danishsajjad/Tic-Tac-Toe/README.md

# Tic-Tac-Toe
 DLD Project. Game made from logic ICs.
