danishsajjad/Tic-Tac-Toe/images/Schematic-Sliced_01.gif

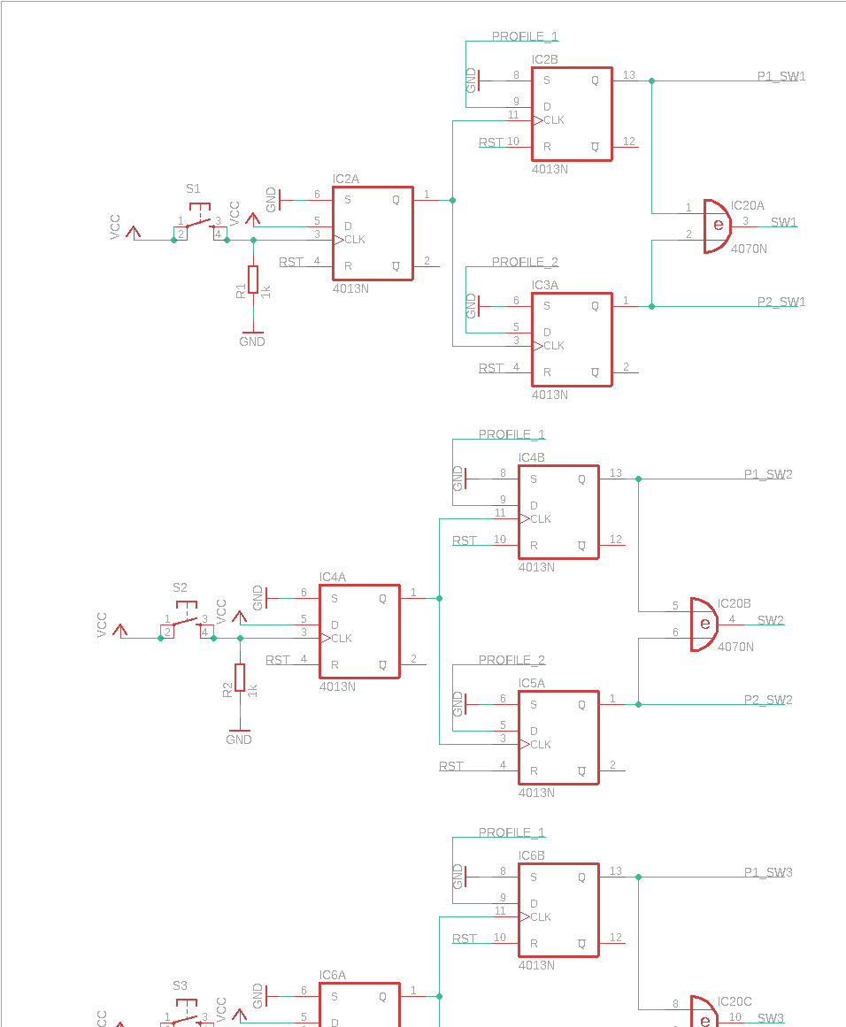
images/Schematic-Sliced_01.gif
