danishsajjad/Tic-Tac-Toe/images/Schematic-Sliced_02.png

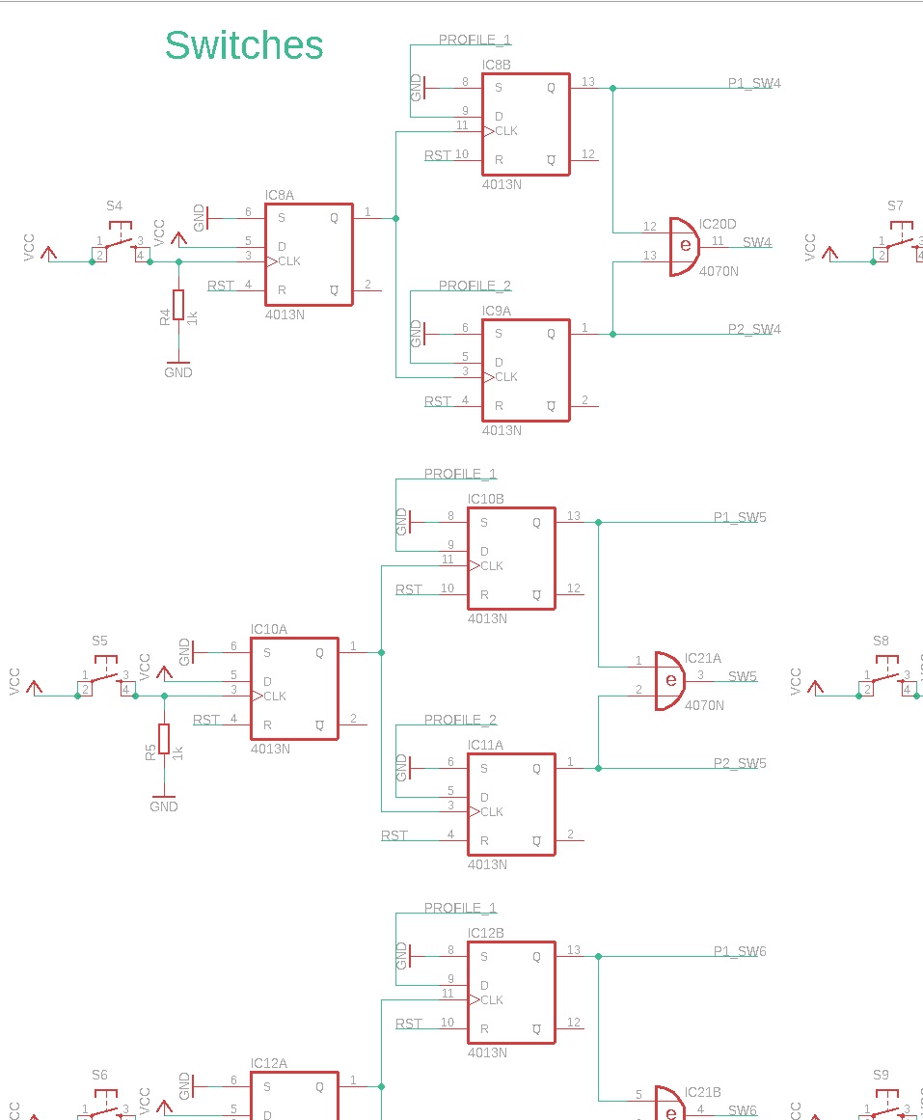
images/Schematic-Sliced_02.png
