danishsajjad/Tic-Tac-Toe/images/Schematic-Sliced_03.gif

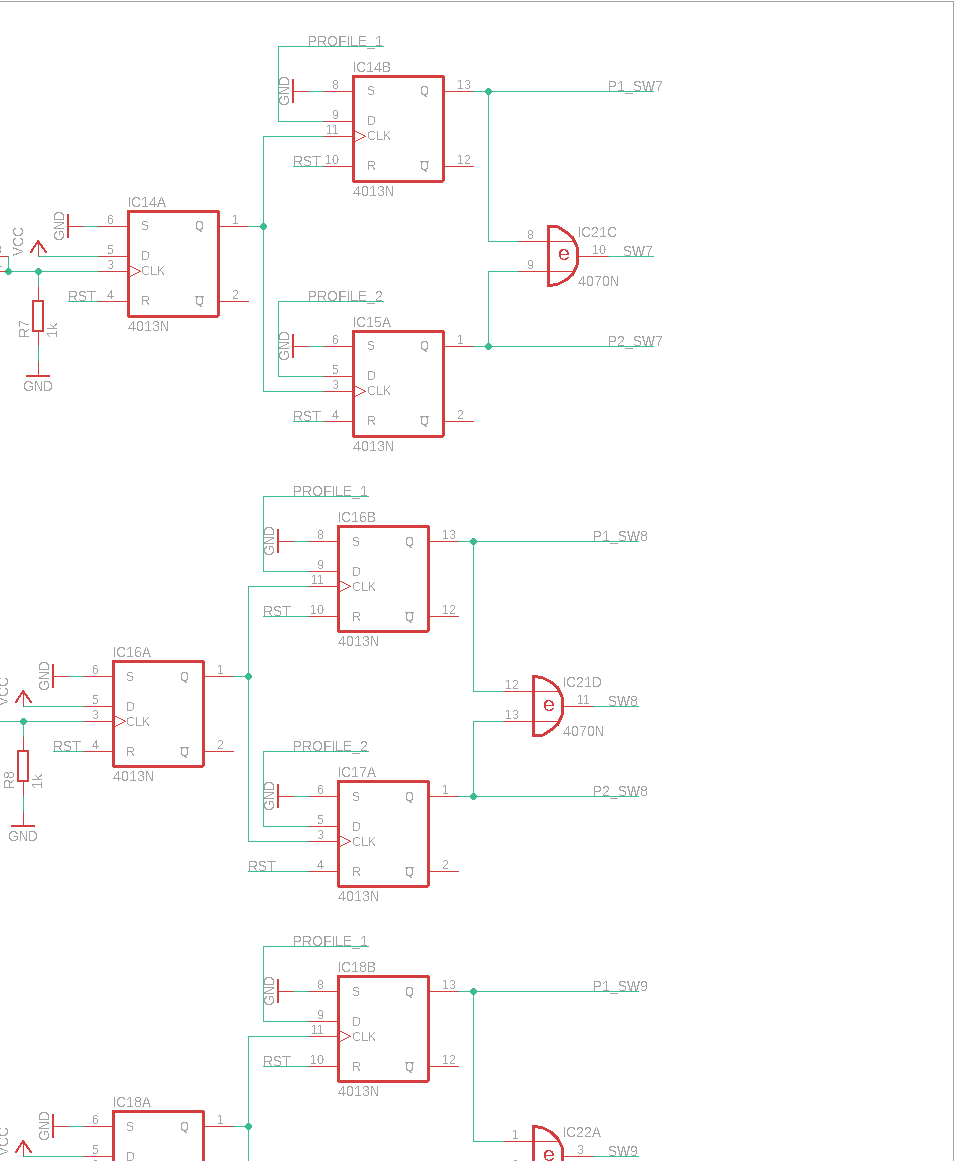
images/Schematic-Sliced_03.gif
