danishsajjad/Tic-Tac-Toe/images/Schematic-Sliced_04.gif

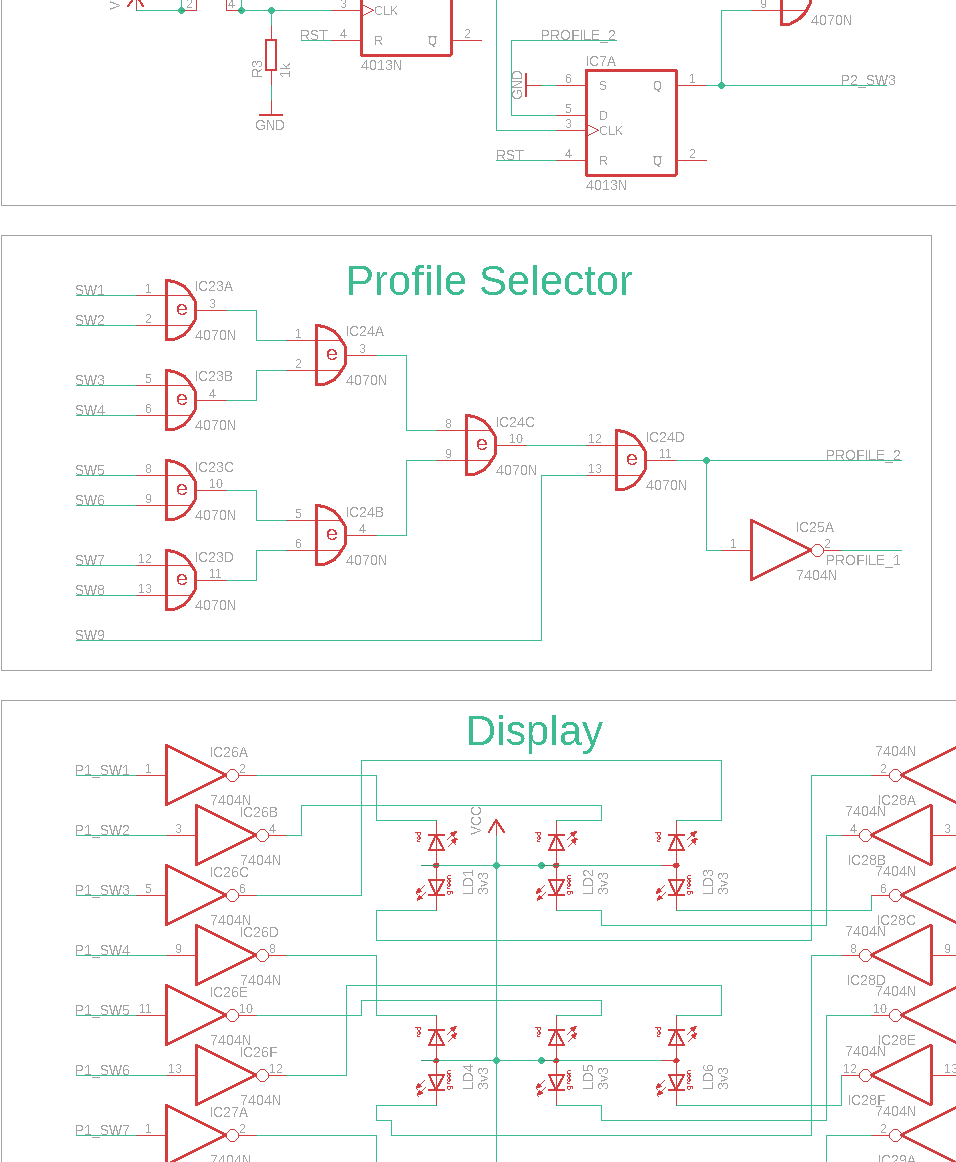
images/Schematic-Sliced_04.gif
