danishsajjad/Tic-Tac-Toe/images/Schematic-Sliced_05.gif

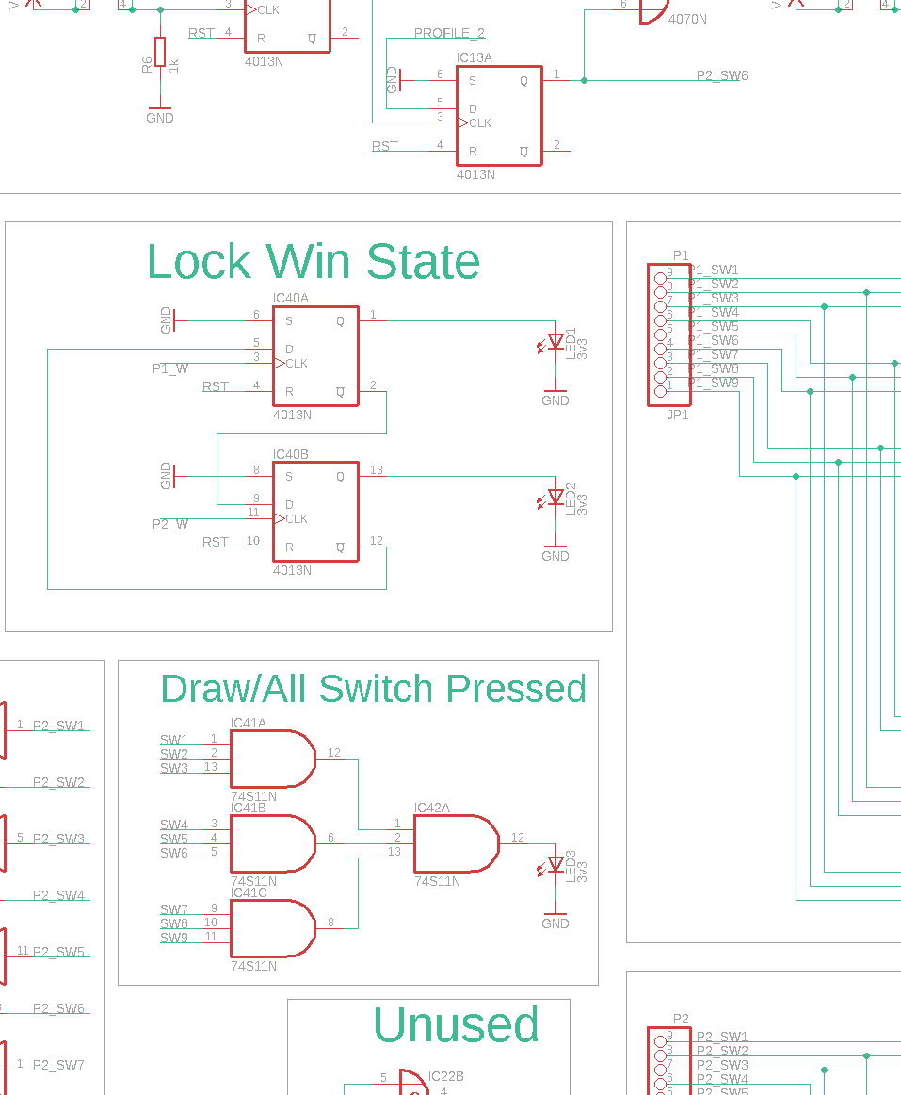
images/Schematic-Sliced_05.gif
