danishsajjad/Tic-Tac-Toe/images/Schematic-Sliced_06.gif

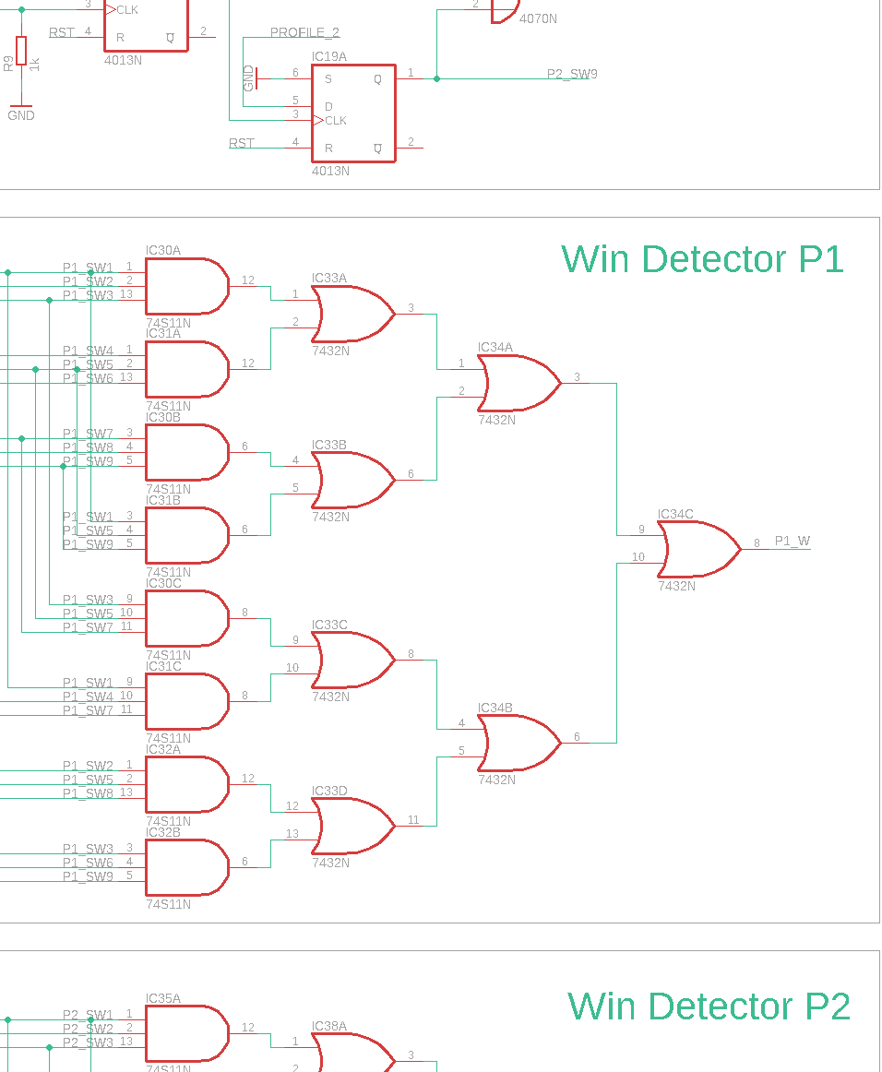
images/Schematic-Sliced_06.gif
