danishsajjad/Tic-Tac-Toe/images/Schematic-Sliced_07.gif

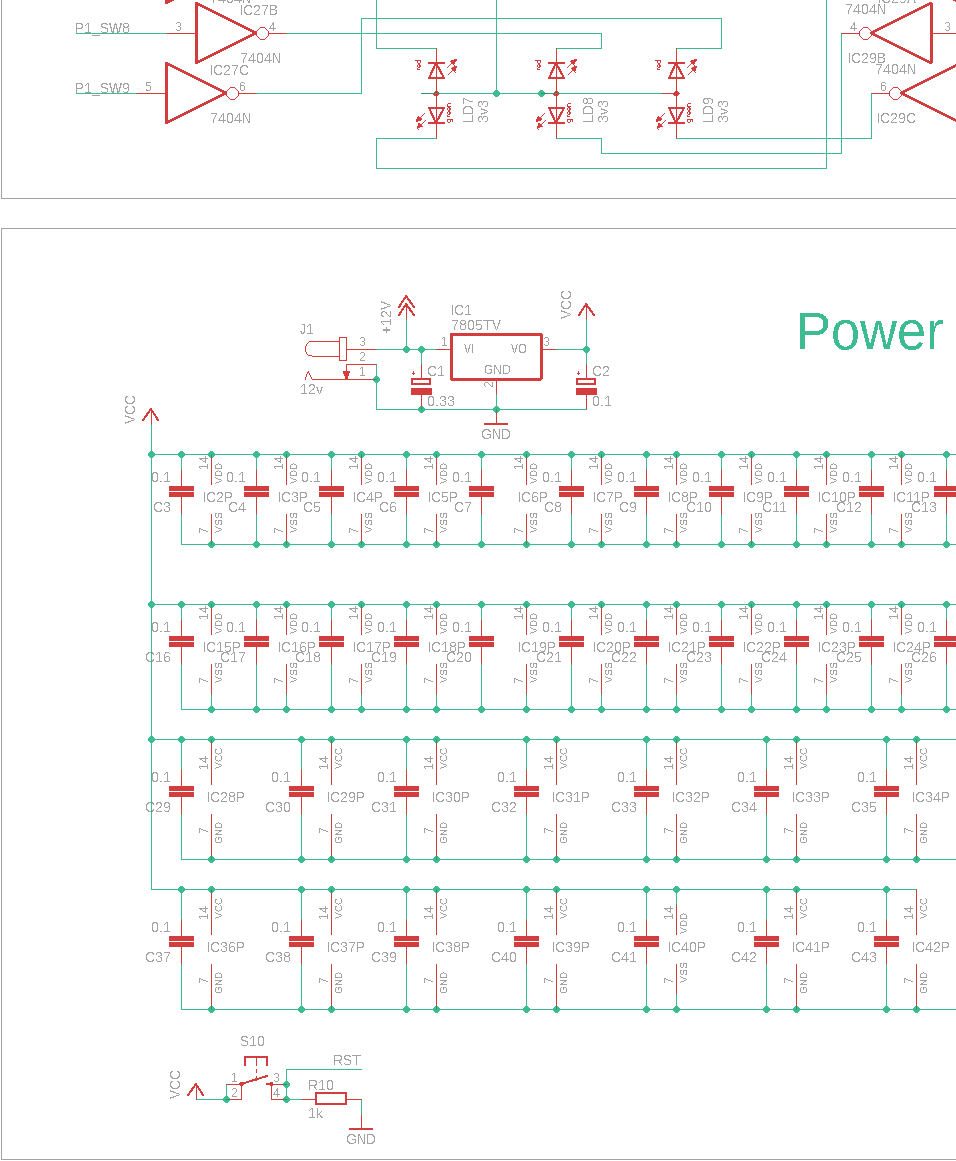
images/Schematic-Sliced_07.gif
