danishsajjad/Tic-Tac-Toe/images/Schematic-Sliced_08.gif

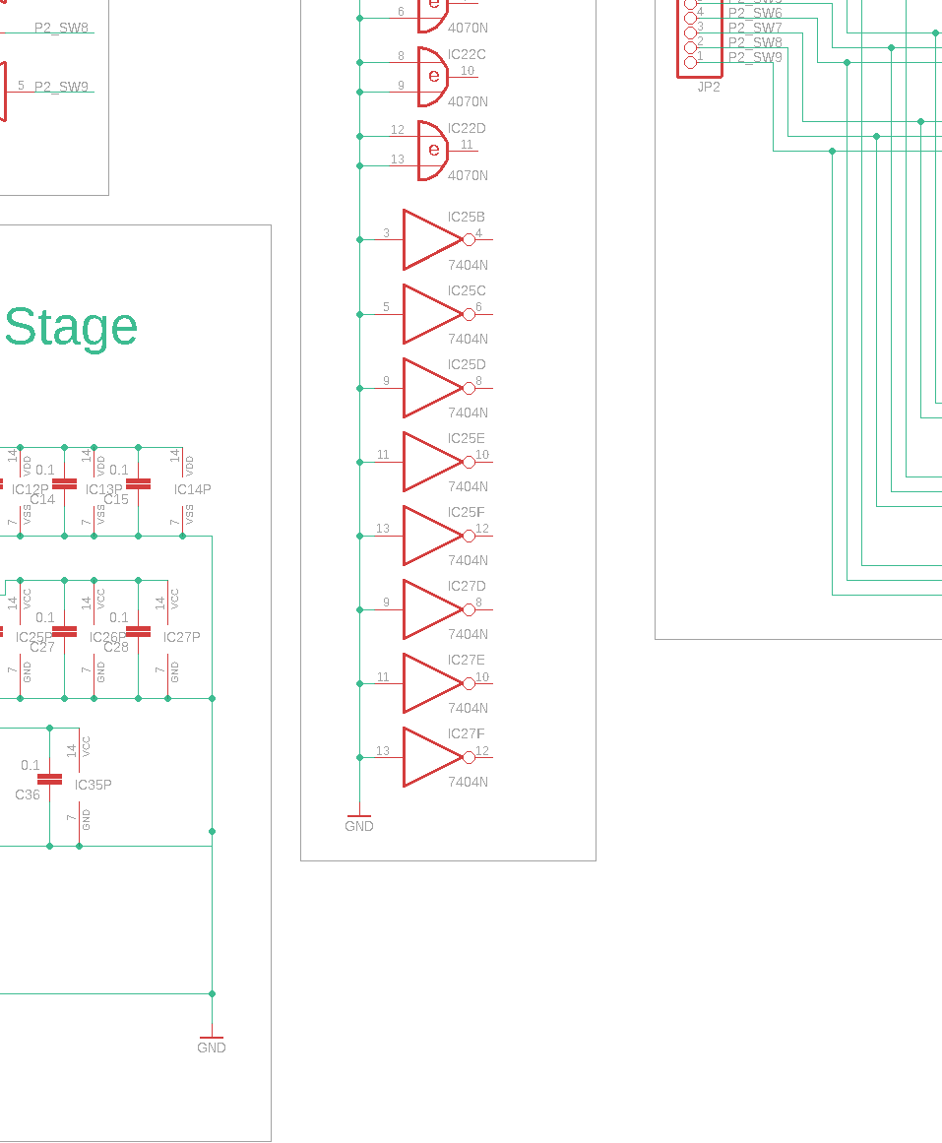
images/Schematic-Sliced_08.gif
