danishsajjad/Tic-Tac-Toe/images/Schematic-Sliced_09.gif

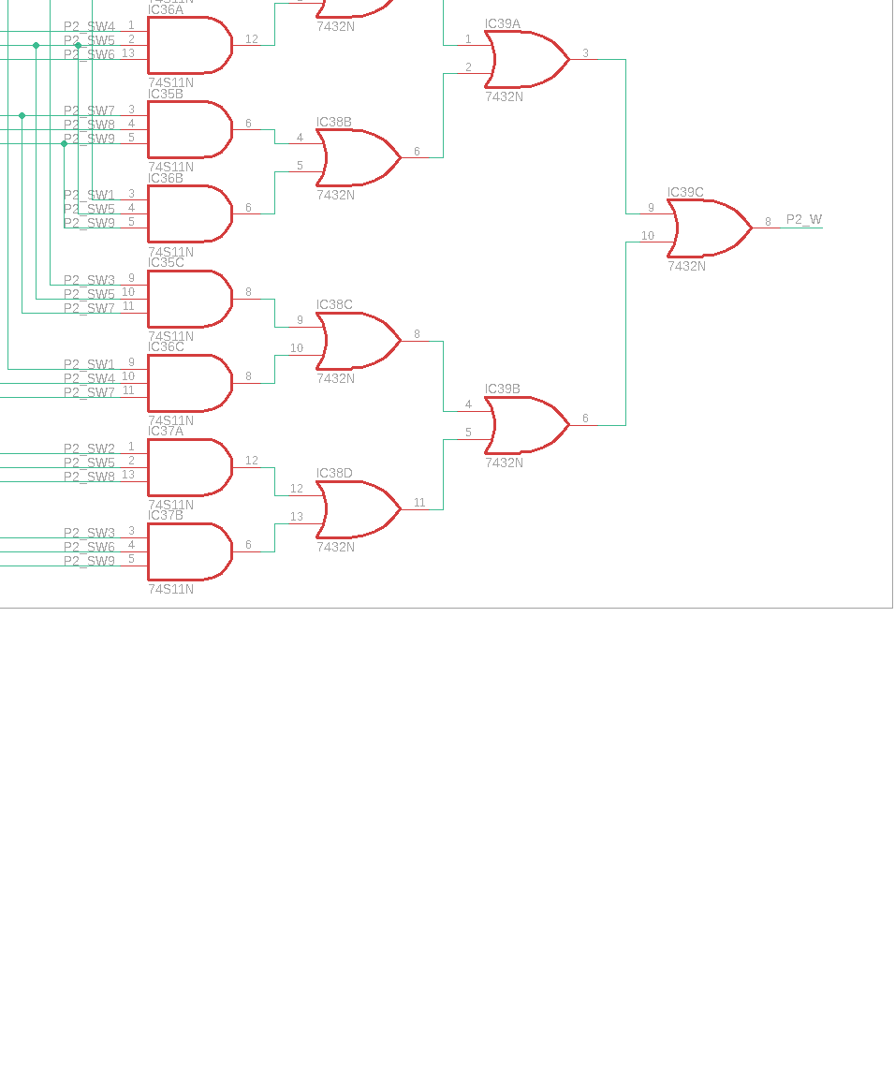
images/Schematic-Sliced_09.gif
