danishsajjad/Tic-Tac-Toe/Lab Report/Draw Indicator.PNG

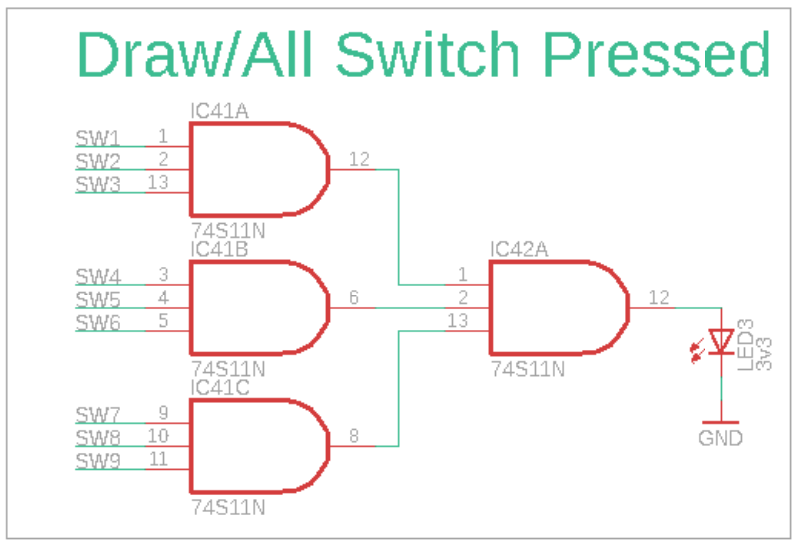
Lab Report/Draw Indicator.PNG
