danishsajjad/Tic-Tac-Toe/Lab Report/Input Stage.PNG

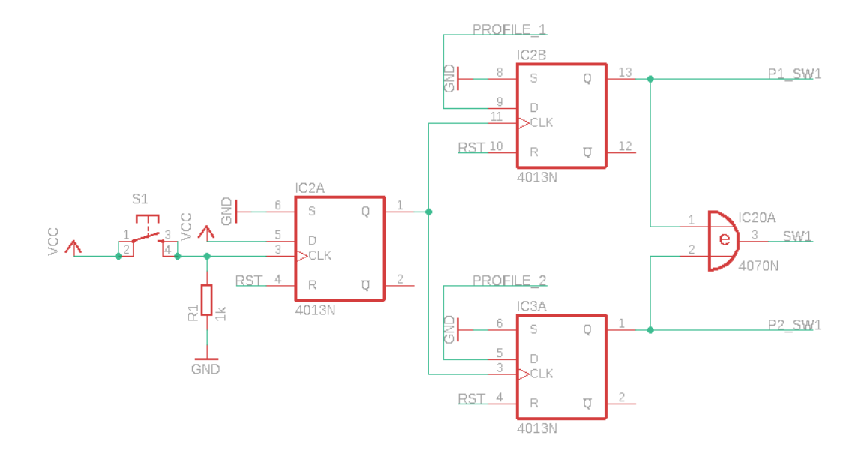
Lab Report/Input Stage.PNG
