danishsajjad/Tic-Tac-Toe/Lab Report/Lock Win State.PNG

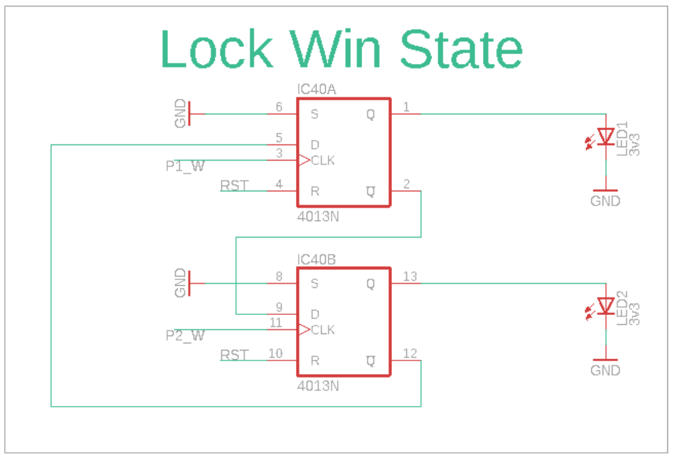
Lab Report/Lock Win State.PNG
