danishsajjad/Tic-Tac-Toe/Lab Report/Profile Selector.PNG

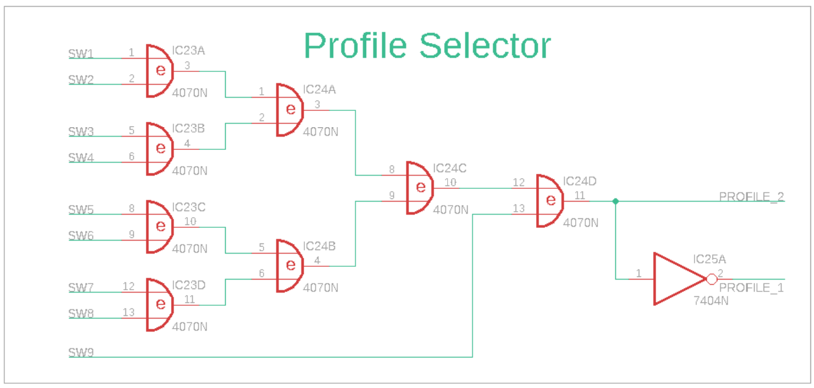
Lab Report/Profile Selector.PNG
