danishsajjad/Tic-Tac-Toe/Lab Report/Win Detector.PNG

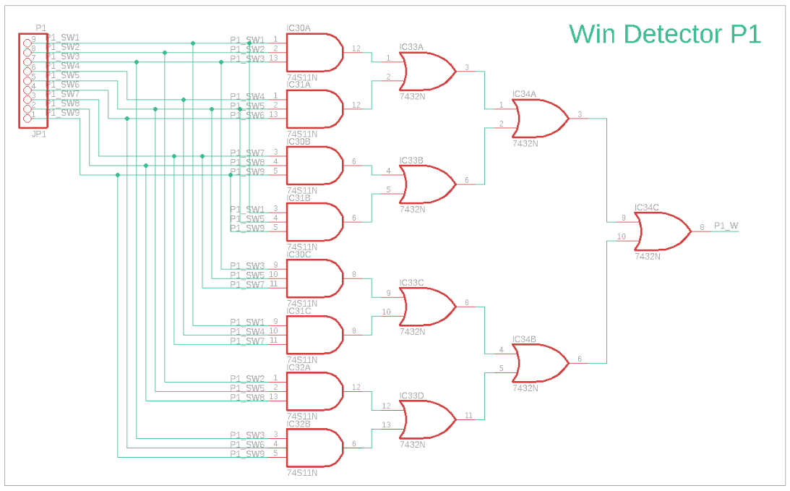
Lab Report/Win Detector.PNG
