danishsajjad/Tic-Tac-Toe/Schematic Sliced.png

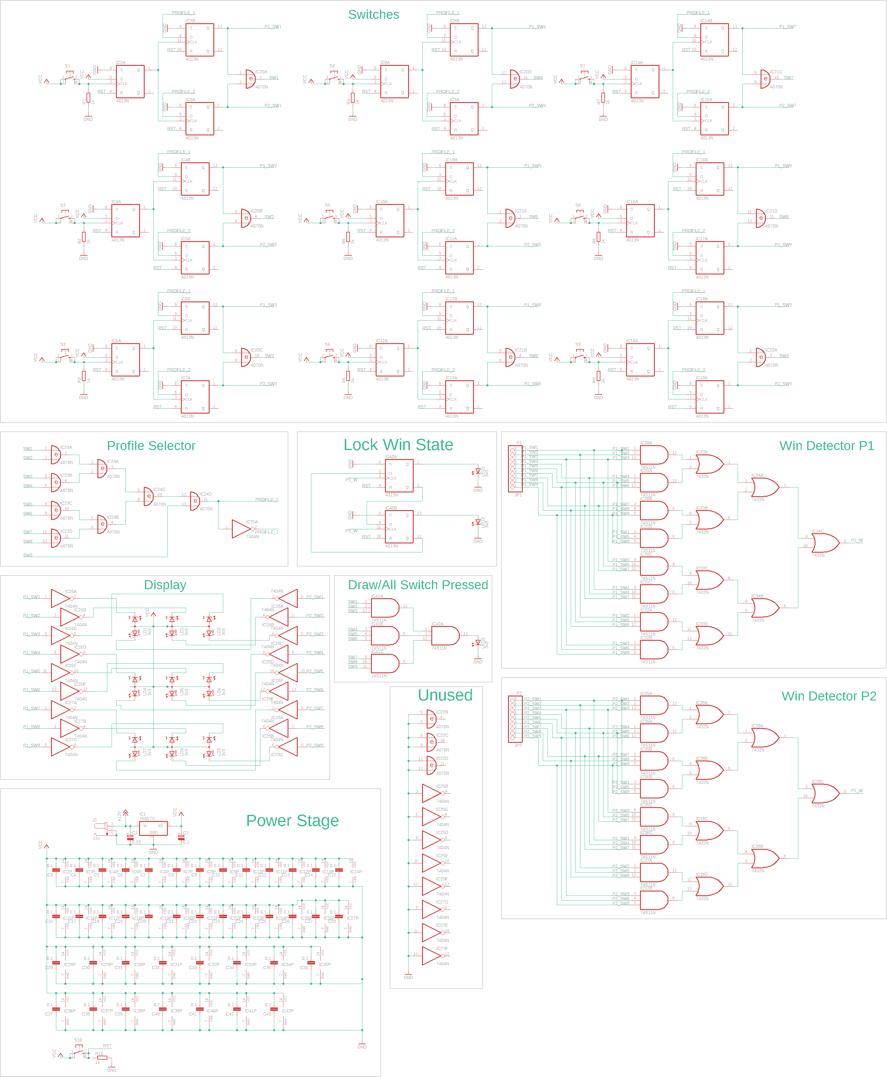
Schematic Sliced.png
