danishsajjad/Tic-Tac-Toe/BOM.xlsx

Qty | Value | Device | Description
10 |  | TAC_SWITCHPTH | Momentary Switch
10 | 1k | R-EU_0207/7 | RESISTOR, European symbol
9 | 3v3 | DUOLED-RG-A | Two Color LED
3 | 3v3 | LED5MM | LED
19 | 4013N | 4013N | Dual D FLIP FLOP, set/reset
5 | 4070N | 4070N | Quad 2-input XOR
5 | 7404N | 7404N | Hex INVERTER
4 | 7432N | 7432N | Quad 2-input OR gate
8 | 74S11N | 74S11N | Triple 3-input AND gate
5 | - | Breadboard | Breadboard
