danishsajjad/Tic-Tac-Toe/(list of files, drawings)

Other design files:
Simulation/Design1.ms13
