danishsajjad/Tic-Tac-Toe/Tic Tac Toe/untitled.sch

## EAGLE design Tic Tac Toe/untitled.sch (2021-04-01)

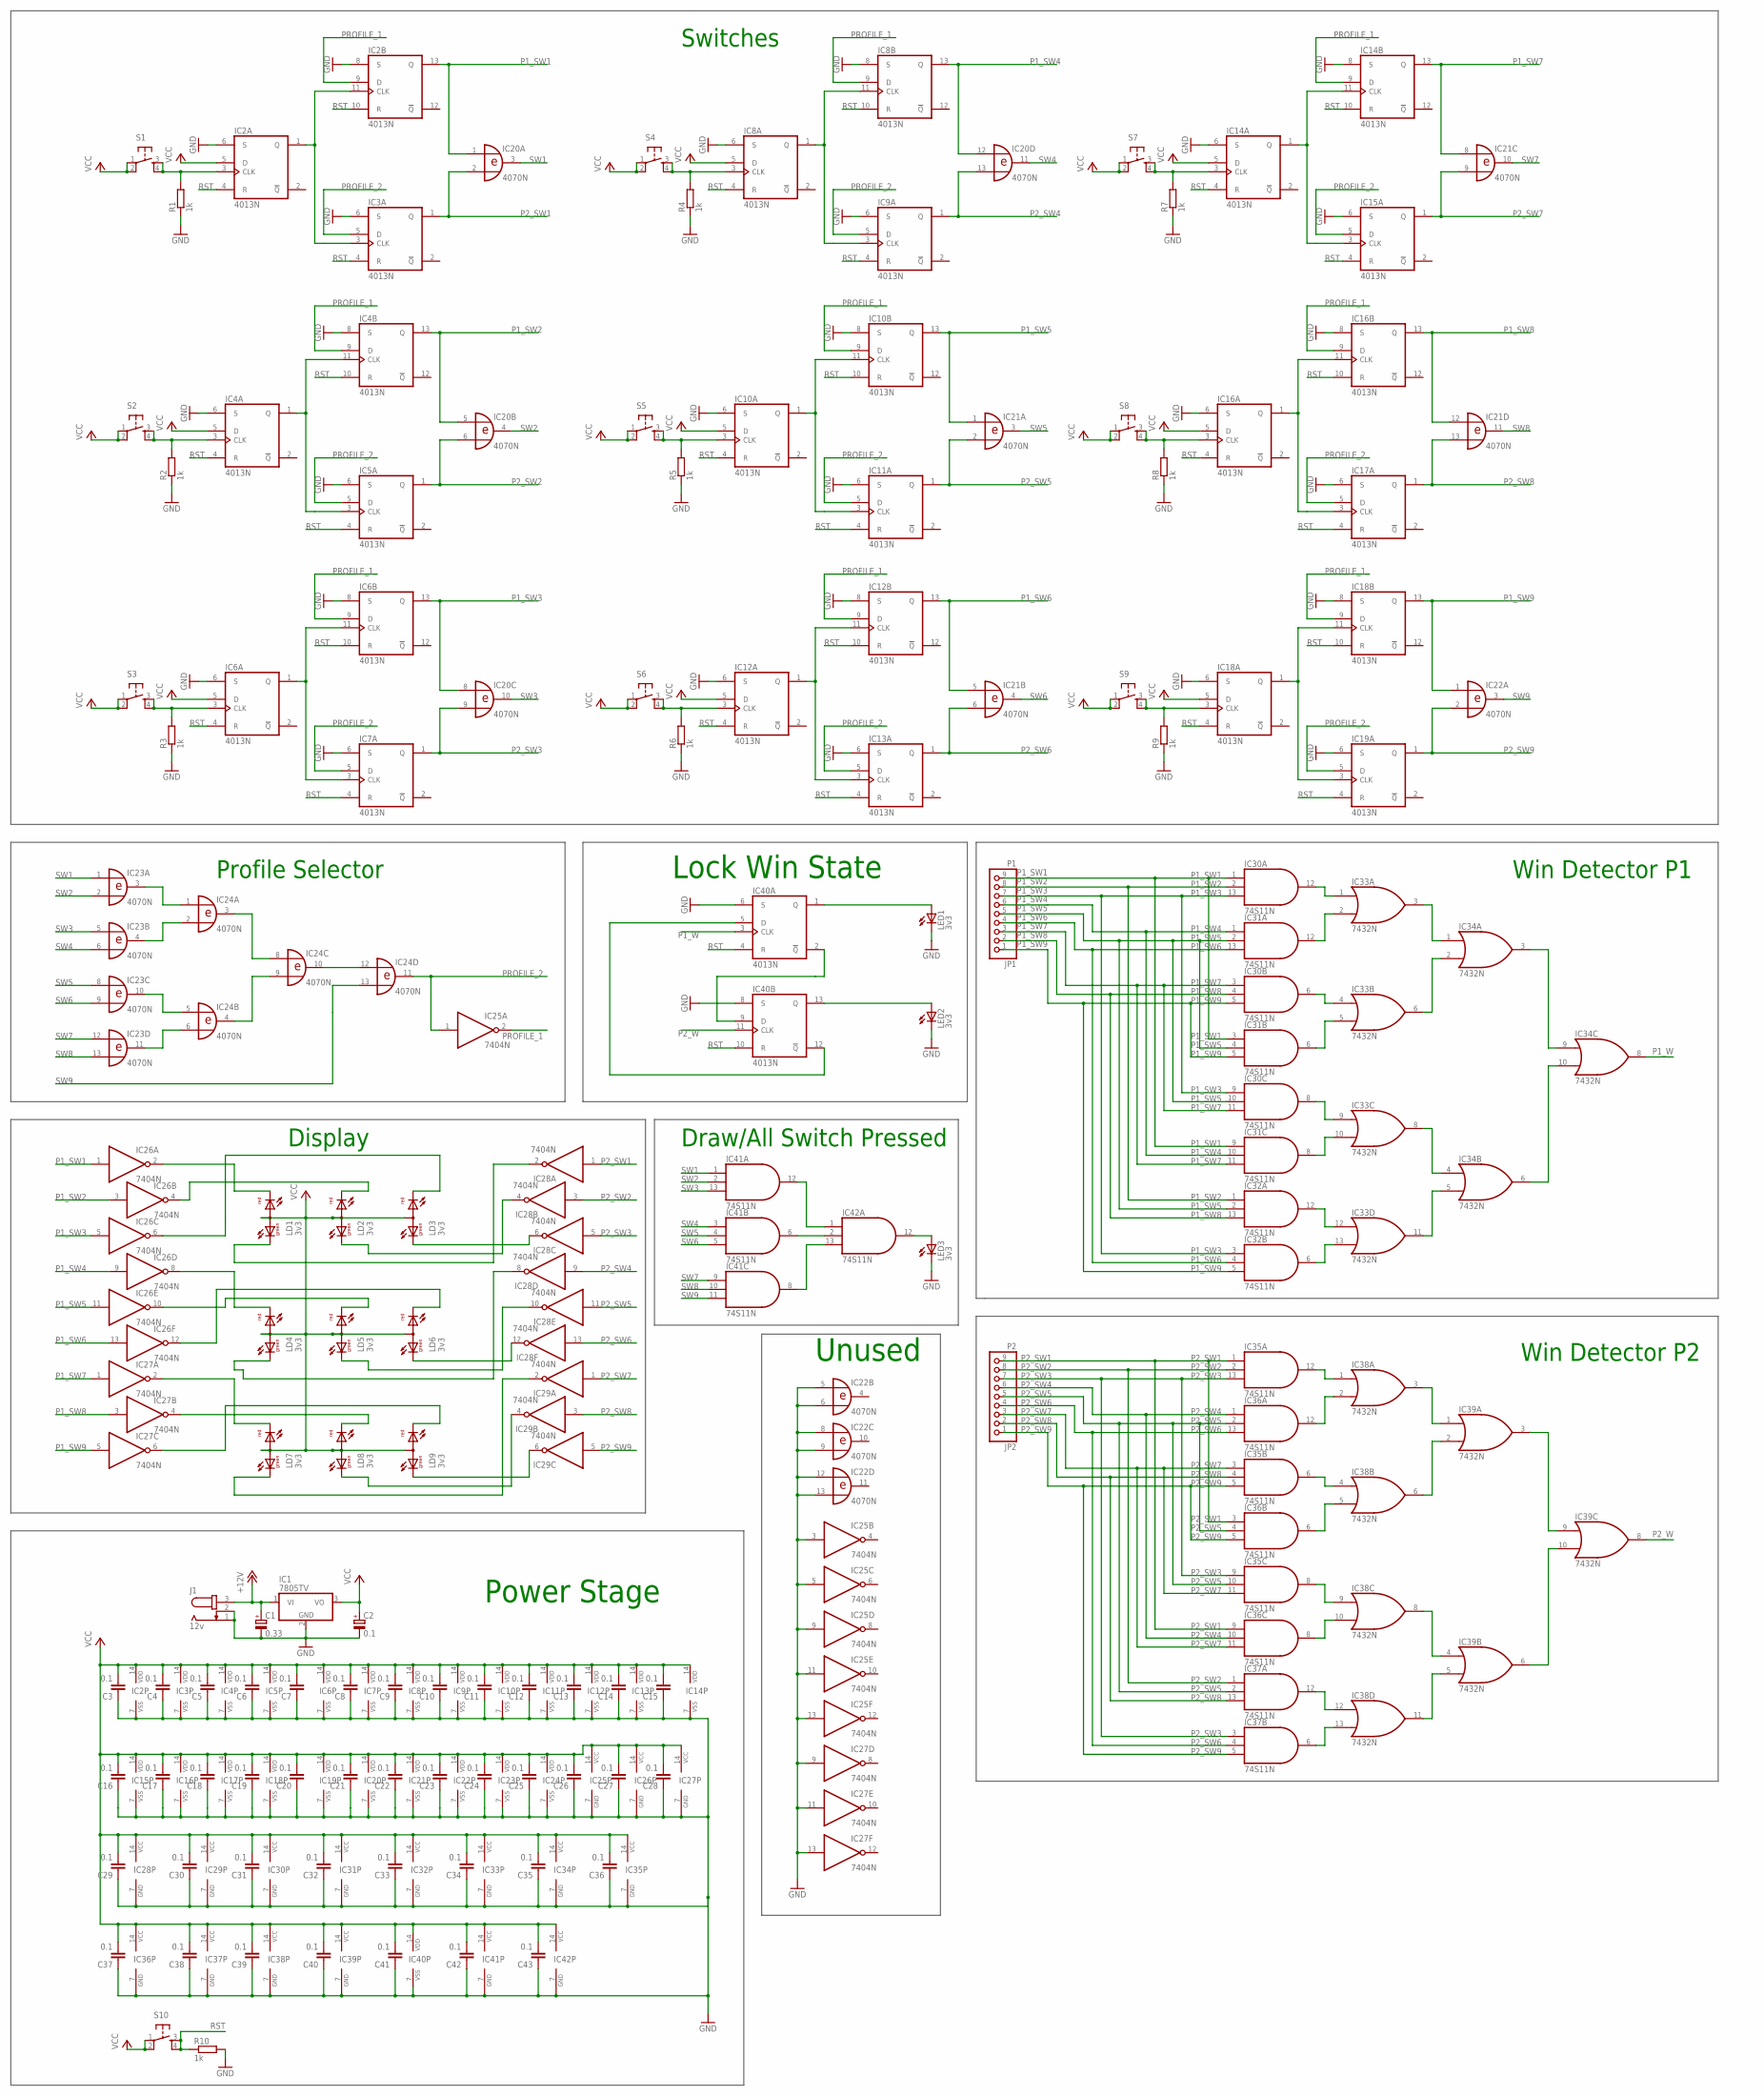
[picture p24: schematic untitled.sch]

Parts:
C1: 0.33; E5-8,5
C2: 0.1; E5-8,5
C3, C4, C5, C6, C7, C8, C9, C10, C11, C12, C13, C14, C15, C16, C17, C18, C19, C20, C21, C22, C23, C24, C25, C26, C27, C28, C29, C30, C31, C32, C33, C34, C35, C36, C37, C38, C39, C40, C41, C42, C43: 0.1; C025-050X050
IC1: 7805TV; TO220V
IC2, IC3, IC4, IC5, IC6, IC7, IC8, IC9, IC10, IC11, IC12, IC13, IC14, IC15, IC16, IC17, IC18, IC19, IC40: 4013N; DIL14
IC20, IC21, IC22, IC23, IC24: 4070N; DIL14
IC25, IC26, IC27, IC28, IC29: 7404N; DIL14
IC30, IC31, IC32, IC35, IC36, IC37, IC41, IC42: 74S11N; DIL14
IC33, IC34, IC38, IC39: 7432N; DIL14
J1: 12v; SPC4077
JP1: P1; 1X09/90
JP2: P2; 1X09/90
LD1, LD2, LD3, LD4, LD5, LD6, LD7, LD8, LD9: 3v3; DUOLED-A-5MM
LED1, LED2, LED3: 3v3; LED5MM
R1, R2, R3, R4, R5, R6, R7, R8, R9, R10: 1k; 0207/7
S1, S2, S3, S4, S5, S6, S7, S8, S9, S10: TAC_SWITCHPTH; TACTILE-PTH

Connections:
+12V: C1.+, IC1.1 (VI), J1.3
GND: C1.-, C2.-, C3.1, C4.1, C5.1, C6.1, C7.1, C8.1, C9.1, C10.1, C11.1, C12.1, C13.1, C14.1, C15.1, C16.1, C17.1, C18.1, C19.1, C20.1, C21.1, C22.1, C23.1, C24.1, C25.1, C26.1, C27.1, C28.1, C29.1, C30.1, C31.1, C32.1, C33.1, C34.1, C35.1, C36.1, C37.1, C38.1, C39.1, C40.1, C41.1, C42.1, C43.1, IC1.2 (GND), IC2.6 (S), IC2.7 (VSS), IC2.8 (S), IC3.6 (S), IC3.7 (VSS), IC4.6 (S), IC4.7 (VSS), IC4.8 (S), IC5.6 (S), IC5.7 (VSS), IC6.6 (S), IC6.7 (VSS), IC6.8 (S), IC7.6 (S), IC7.7 (VSS), IC8.6 (S), IC8.7 (VSS), IC8.8 (S), IC9.6 (S), IC9.7 (VSS), IC10.6 (S), IC10.7 (VSS), IC10.8 (S), IC11.6 (S), IC11.7 (VSS), IC12.6 (S), IC12.7 (VSS), IC12.8 (S), IC13.6 (S), IC13.7 (VSS), IC14.6 (S), IC14.7 (VSS), IC14.8 (S), IC15.6 (S), IC15.7 (VSS), IC16.6 (S), IC16.7 (VSS), IC16.8 (S), IC17.6 (S), IC17.7 (VSS), IC18.6 (S), IC18.7 (VSS), IC18.8 (S), IC19.6 (S), IC19.7 (VSS), IC20.7 (VSS), IC21.7 (VSS), IC22.5 (I0), IC22.6 (I1), IC22.7 (VSS), IC22.8 (I0), IC22.9 (I1), IC22.12 (I0), IC22.13 (I1), IC23.7 (VSS), IC24.7 (VSS), IC25.3 (I), IC25.5 (I), IC25.7 (GND), IC25.9 (I), IC25.11 (I), IC25.13 (I), IC26.7 (GND), IC27.7 (GND), IC27.9 (I), IC27.11 (I), IC27.13 (I), IC28.7 (GND), IC29.7 (GND), IC30.7 (GND), IC31.7 (GND), IC32.7 (GND), IC33.7 (GND), IC34.7 (GND), IC35.7 (GND), IC36.7 (GND), IC37.7 (GND), IC38.7 (GND), IC39.7 (GND), IC40.6 (S), IC40.7 (VSS), IC40.8 (S), IC41.7 (GND), IC42.7 (GND), J1.1, J1.2, LED1.K (C), LED2.K (C), LED3.K (C), R1.1, R2.1, R3.1, R4.1, R5.1, R6.1, R7.1, R8.1, R9.1, R10.2
unnamed: IC2.3 (CLK), R1.2, S1.3, S1.4
unnamed: IC2.1 (Q), IC2.11 (CLK), IC3.3 (CLK)
unnamed: IC4.3 (CLK), R2.2, S2.3, S2.4
unnamed: IC4.1 (Q), IC4.11 (CLK), IC5.3 (CLK)
unnamed: IC6.3 (CLK), R3.2, S3.3, S3.4
unnamed: IC6.1 (Q), IC6.11 (CLK), IC7.3 (CLK)
unnamed: IC8.3 (CLK), R4.2, S4.3, S4.4
unnamed: IC8.1 (Q), IC8.11 (CLK), IC9.3 (CLK)
unnamed: IC10.3 (CLK), R5.2, S5.3, S5.4
unnamed: IC10.1 (Q), IC10.11 (CLK), IC11.3 (CLK)
unnamed: IC12.3 (CLK), R6.2, S6.3, S6.4
unnamed: IC12.1 (Q), IC12.11 (CLK), IC13.3 (CLK)
unnamed: IC14.3 (CLK), R7.2, S7.3, S7.4
unnamed: IC14.1 (Q), IC14.11 (CLK), IC15.3 (CLK)
unnamed: IC16.3 (CLK), R8.2, S8.3, S8.4
unnamed: IC16.1 (Q), IC16.11 (CLK), IC17.3 (CLK)
unnamed: IC18.3 (CLK), R9.2, S9.3, S9.4
unnamed: IC18.1 (Q), IC18.11 (CLK), IC19.3 (CLK)
unnamed: IC23.3 (O), IC24.1 (I0)
unnamed: IC23.4 (O), IC24.2 (I1)
unnamed: IC23.10 (O), IC24.5 (I0)
unnamed: IC23.11 (O), IC24.6 (I1)
unnamed: IC24.3 (O), IC24.8 (I0)
unnamed: IC24.4 (O), IC24.9 (I1)
unnamed: IC24.10 (O), IC24.12 (I0)
unnamed: IC30.12 (O), IC33.1 (I0)
unnamed: IC31.12 (O), IC33.2 (I1)
unnamed: IC27.2 (O), LD7.CR
unnamed: IC26.2 (O), LD1.CR
unnamed: IC26.8 (O), LD4.CR
unnamed: IC30.6 (O), IC33.4 (I0)
unnamed: IC29.2 (O), LD7.CX (CG)
unnamed: IC28.8 (O), LD4.CX (CG)
unnamed: IC28.2 (O), LD1.CX (CG)
unnamed: IC26.4 (O), LD2.CR
unnamed: IC28.4 (O), LD2.CX (CG)
unnamed: IC26.10 (O), LD5.CR
unnamed: IC28.10 (O), LD5.CX (CG)
unnamed: IC27.4 (O), LD8.CR
unnamed: IC29.4 (O), LD8.CX (CG)
unnamed: IC26.6 (O), LD3.CR
unnamed: IC28.6 (O), LD3.CX (CG)
unnamed: IC26.12 (O), LD6.CR
unnamed: IC28.12 (O), LD6.CX (CG)
unnamed: IC27.6 (O), LD9.CR
unnamed: IC29.6 (O), LD9.CX (CG)
unnamed: IC31.6 (O), IC33.5 (I1)
unnamed: IC33.3 (O), IC34.1 (I0)
unnamed: IC33.6 (O), IC34.2 (I1)
unnamed: IC30.8 (O), IC33.9 (I0)
unnamed: IC31.8 (O), IC33.10 (I1)
unnamed: IC40.1 (Q), LED1.A
unnamed: IC40.13 (Q), LED2.A
unnamed: IC40.2 (!Q), IC40.9 (D)
unnamed: IC41.6 (O), IC42.2 (I1)
unnamed: IC41.8 (O), IC42.13 (I2)
unnamed: IC40.5 (D), IC40.12 (!Q)
unnamed: IC41.12 (O), IC42.1 (I0)
unnamed: IC32.12 (O), IC33.12 (I0)
unnamed: IC32.6 (O), IC33.13 (I1)
unnamed: IC33.8 (O), IC34.4 (I0)
unnamed: IC33.11 (O), IC34.5 (I1)
unnamed: IC34.3 (O), IC34.9 (I0)
unnamed: IC34.6 (O), IC34.10 (I1)
unnamed: IC35.12 (O), IC38.1 (I0)
unnamed: IC36.12 (O), IC38.2 (I1)
unnamed: IC35.6 (O), IC38.4 (I0)
unnamed: IC36.6 (O), IC38.5 (I1)
unnamed: IC38.3 (O), IC39.1 (I0)
unnamed: IC38.6 (O), IC39.2 (I1)
unnamed: IC35.8 (O), IC38.9 (I0)
unnamed: IC36.8 (O), IC38.10 (I1)
unnamed: IC37.12 (O), IC38.12 (I0)
unnamed: IC37.6 (O), IC38.13 (I1)
unnamed: IC38.8 (O), IC39.4 (I0)
unnamed: IC38.11 (O), IC39.5 (I1)
unnamed: IC39.3 (O), IC39.9 (I0)
unnamed: IC39.6 (O), IC39.10 (I1)
unnamed: IC42.12 (O), LED3.A
P1_SW1: IC2.13 (Q), IC20.1 (I0), IC26.1 (I), IC30.1 (I0), IC31.3 (I0), IC31.9 (I0), JP1.9
P1_SW2: IC4.13 (Q), IC20.5 (I0), IC26.3 (I), IC30.2 (I1), IC32.1 (I0), JP1.8
P1_SW3: IC6.13 (Q), IC20.8 (I0), IC26.5 (I), IC30.9 (I0), IC30.13 (I2), IC32.3 (I0), JP1.7
P1_SW4: IC8.13 (Q), IC20.12 (I0), IC26.9 (I), IC31.1 (I0), IC31.10 (I1), JP1.6
P1_SW5: IC10.13 (Q), IC21.1 (I0), IC26.11 (I), IC30.10 (I1), IC31.2 (I1), IC31.4 (I1), IC32.2 (I1), JP1.5
P1_SW6: IC12.13 (Q), IC21.5 (I0), IC26.13 (I), IC31.13 (I2), IC32.4 (I1), JP1.4
P1_SW7: IC14.13 (Q), IC21.8 (I0), IC27.1 (I), IC30.3 (I0), IC30.11 (I2), IC31.11 (I2), JP1.3
P1_SW8: IC16.13 (Q), IC21.12 (I0), IC27.3 (I), IC30.4 (I1), IC32.13 (I2), JP1.2
P1_SW9: IC18.13 (Q), IC22.1 (I0), IC27.5 (I), IC30.5 (I2), IC31.5 (I2), IC32.5 (I2), JP1.1
P1_W: IC34.8 (O), IC40.3 (CLK)
P2_SW1: IC3.1 (Q), IC20.2 (I1), IC28.1 (I), IC35.1 (I0), IC36.3 (I0), IC36.9 (I0), JP2.9
P2_SW2: IC5.1 (Q), IC20.6 (I1), IC28.3 (I), IC35.2 (I1), IC37.1 (I0), JP2.8
P2_SW3: IC7.1 (Q), IC20.9 (I1), IC28.5 (I), IC35.9 (I0), IC35.13 (I2), IC37.3 (I0), JP2.7
P2_SW4: IC9.1 (Q), IC20.13 (I1), IC28.9 (I), IC36.1 (I0), IC36.10 (I1), JP2.6
P2_SW5: IC11.1 (Q), IC21.2 (I1), IC28.11 (I), IC35.10 (I1), IC36.2 (I1), IC36.4 (I1), IC37.2 (I1), JP2.5
P2_SW6: IC13.1 (Q), IC21.6 (I1), IC28.13 (I), IC36.13 (I2), IC37.4 (I1), JP2.4
P2_SW7: IC15.1 (Q), IC21.9 (I1), IC29.1 (I), IC35.3 (I0), IC35.11 (I2), IC36.11 (I2), JP2.3
P2_SW8: IC17.1 (Q), IC21.13 (I1), IC29.3 (I), IC35.4 (I1), IC37.13 (I2), JP2.2
P2_SW9: IC19.1 (Q), IC22.2 (I1), IC29.5 (I), IC35.5 (I2), IC36.5 (I2), IC37.5 (I2), JP2.1
P2_W: IC39.8 (O), IC40.11 (CLK)
PROFILE_1: IC2.9 (D), IC4.9 (D), IC6.9 (D), IC8.9 (D), IC10.9 (D), IC12.9 (D), IC14.9 (D), IC16.9 (D), IC18.9 (D), IC25.2 (O)
PROFILE_2: IC3.5 (D), IC5.5 (D), IC7.5 (D), IC9.5 (D), IC11.5 (D), IC13.5 (D), IC15.5 (D), IC17.5 (D), IC19.5 (D), IC24.11 (O), IC25.1 (I)
RST: IC2.4 (R), IC2.10 (R), IC3.4 (R), IC4.4 (R), IC4.10 (R), IC5.4 (R), IC6.4 (R), IC6.10 (R), IC7.4 (R), IC8.4 (R), IC8.10 (R), IC9.4 (R), IC10.4 (R), IC10.10 (R), IC11.4 (R), IC12.4 (R), IC12.10 (R), IC13.4 (R), IC14.4 (R), IC14.10 (R), IC15.4 (R), IC16.4 (R), IC16.10 (R), IC17.4 (R), IC18.4 (R), IC18.10 (R), IC19.4 (R), IC40.4 (R), IC40.10 (R), R10.1, S10.3, S10.4
SW1: IC20.3 (O), IC23.1 (I0), IC41.1 (I0)
SW2: IC20.4 (O), IC23.2 (I1), IC41.2 (I1)
SW3: IC20.10 (O), IC23.5 (I0), IC41.13 (I2)
SW4: IC20.11 (O), IC23.6 (I1), IC41.3 (I0)
SW5: IC21.3 (O), IC23.8 (I0), IC41.4 (I1)
SW6: IC21.4 (O), IC23.9 (I1), IC41.5 (I2)
SW7: IC21.10 (O), IC23.12 (I0), IC41.9 (I0)
SW8: IC21.11 (O), IC23.13 (I1), IC41.10 (I1)
SW9: IC22.3 (O), IC24.13 (I1), IC41.11 (I2)
VCC: C2.+, C3.2, C4.2, C5.2, C6.2, C7.2, C8.2, C9.2, C10.2, C11.2, C12.2, C13.2, C14.2, C15.2, C16.2, C17.2, C18.2, C19.2, C20.2, C21.2, C22.2, C23.2, C24.2, C25.2, C26.2, C27.2, C28.2, C29.2, C30.2, C31.2, C32.2, C33.2, C34.2, C35.2, C36.2, C37.2, C38.2, C39.2, C40.2, C41.2, C42.2, C43.2, IC1.3 (VO), IC2.5 (D), IC2.14 (VDD), IC3.14 (VDD), IC4.5 (D), IC4.14 (VDD), IC5.14 (VDD), IC6.5 (D), IC6.14 (VDD), IC7.14 (VDD), IC8.5 (D), IC8.14 (VDD), IC9.14 (VDD), IC10.5 (D), IC10.14 (VDD), IC11.14 (VDD), IC12.5 (D), IC12.14 (VDD), IC13.14 (VDD), IC14.5 (D), IC14.14 (VDD), IC15.14 (VDD), IC16.5 (D), IC16.14 (VDD), IC17.14 (VDD), IC18.5 (D), IC18.14 (VDD), IC19.14 (VDD), IC20.14 (VDD), IC21.14 (VDD), IC22.14 (VDD), IC23.14 (VDD), IC24.14 (VDD), IC25.14 (VCC), IC26.14 (VCC), IC27.14 (VCC), IC28.14 (VCC), IC29.14 (VCC), IC30.14 (VCC), IC31.14 (VCC), IC32.14 (VCC), IC33.14 (VCC), IC34.14 (VCC), IC35.14 (VCC), IC36.14 (VCC), IC37.14 (VCC), IC38.14 (VCC), IC39.14 (VCC), IC40.14 (VDD), IC41.14 (VCC), IC42.14 (VCC), LD1.A, LD2.A, LD3.A, LD4.A, LD5.A, LD6.A, LD7.A, LD8.A, LD9.A, S1.1, S1.2, S2.1, S2.2, S3.1, S3.2, S4.1, S4.2, S5.1, S5.2, S6.1, S6.2, S7.1, S7.2, S8.1, S8.2, S9.1, S9.2, S10.1, S10.2

Notes on the sheet:
Switches
Profile Selector
Display
Win Detector P1
Win Detector P2
Lock Win State
Draw/All Switch Pressed
Power Stage
Unused
